Chaima-Jabri/Self-Balancing-Robot/Presentation&Rapport/Presentation projet CAO.pptx.pdf

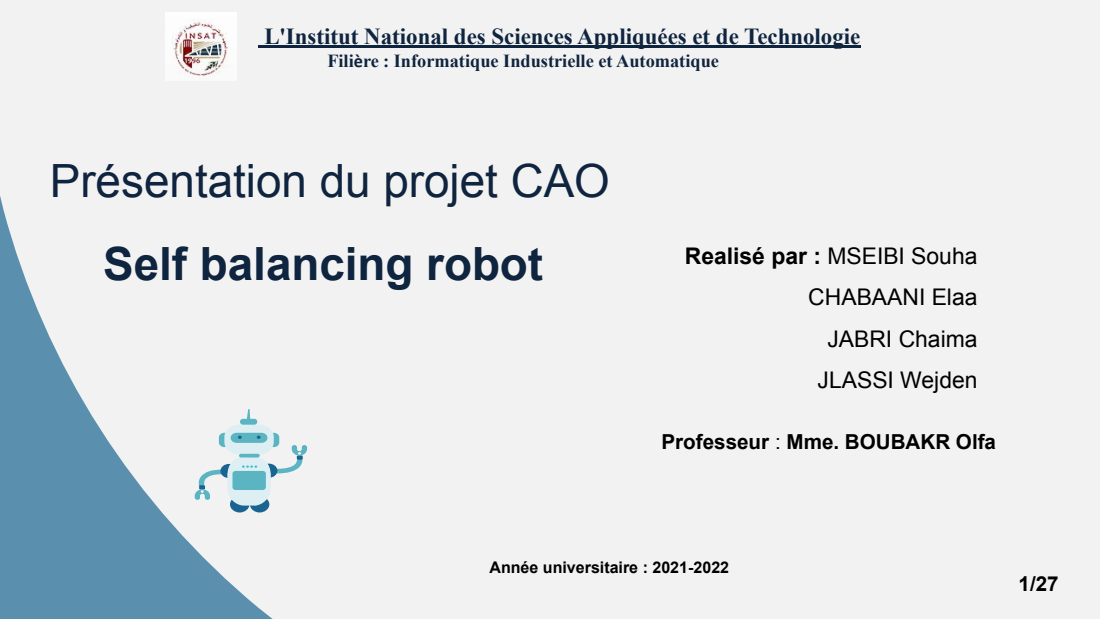
[picture p1: page 1]
Self balancing robot; Realisé par : MSEIBI Souha; CHABAANI Elaa; JABRI Chaima; JLASSI Wejden; Année universitaire : 2021-2022

L'Institut National des Sciences Appliquées et de Technologie

Filière : Informatique Industrielle et Automatique

Présentation du projet CAO

Professeur : Mme. BOUBAKR Olfa

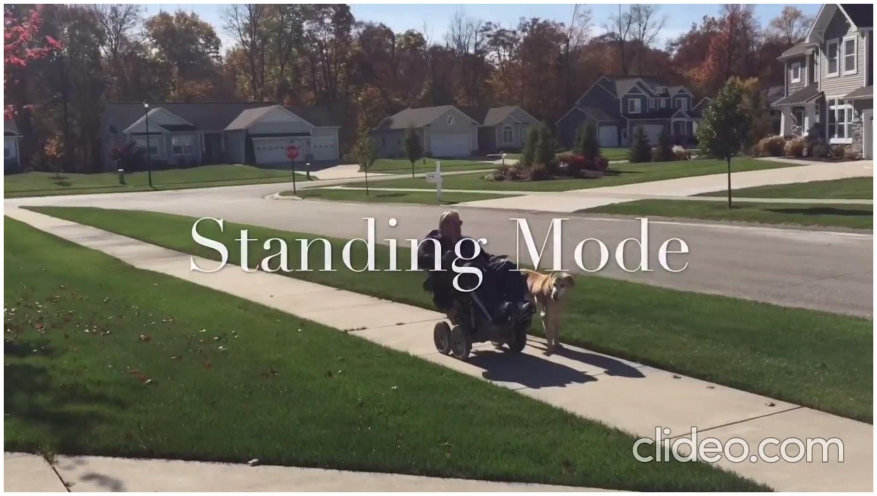
[picture p2: page 2]

Exemple d'application réel du concept d'un robot auto équilibrant (https://docs.google.com/file/d/1WviOFnjOAZ5Zq5dg2Hx27nzAXcQrJKgC/preview)

# Plan

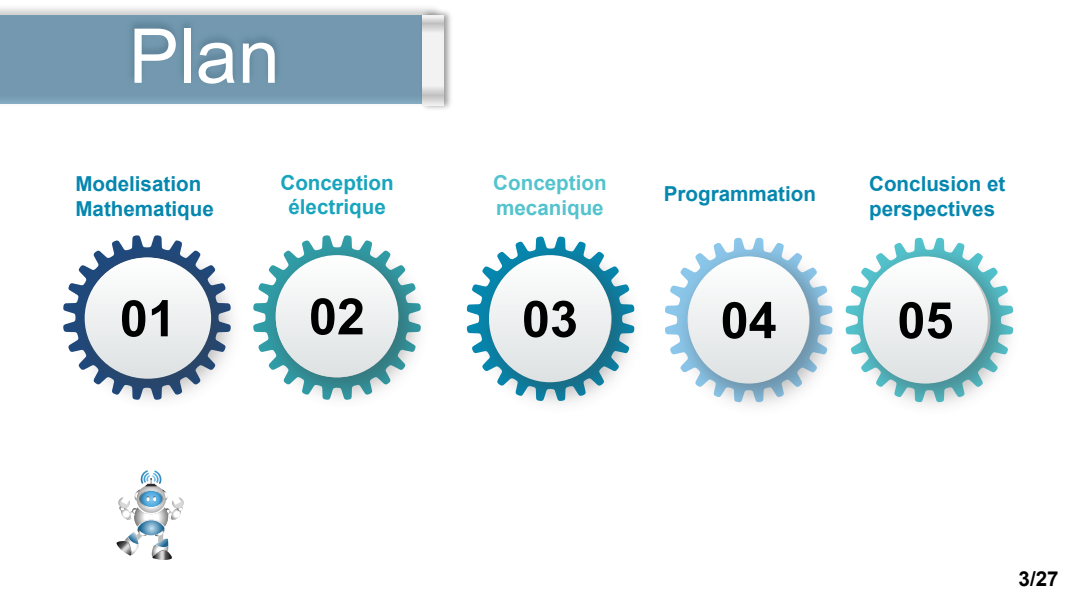
[picture p3: page 3]
Modelisation Mathematique; Conception électrique; Conception; mecanique; Programmation; Conclusion et; perspectives

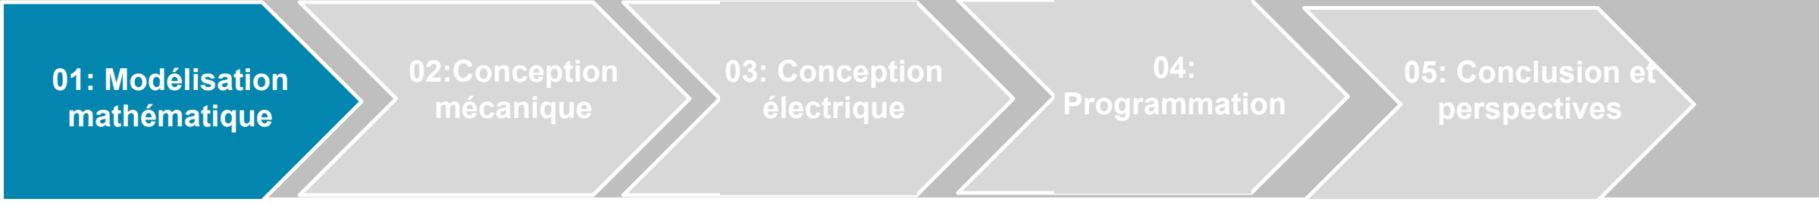
[picture p4: figure]
01: Modélisation mathématique; 02:Conception mécanique; 03: Conception électrique; 04: Programmation; 05: Conclusion et perspectives

## Modélisation et équations mathématiques :

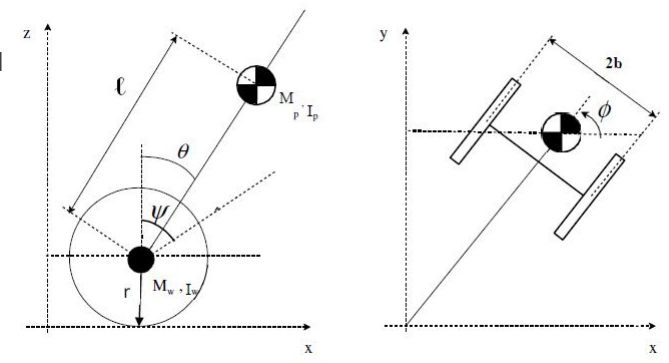
[picture p5: figure]

| on peut modéliser le robot en un sous-système mécanique qui se compose du corps du robot et de deux roues.
| Le corps peut être modélisé comme un pendule inversé avec la masse concentrée au centre de gravité et l'axe de rotation au-dessus de l'axe de roues.

4/27

## Assignations des variables

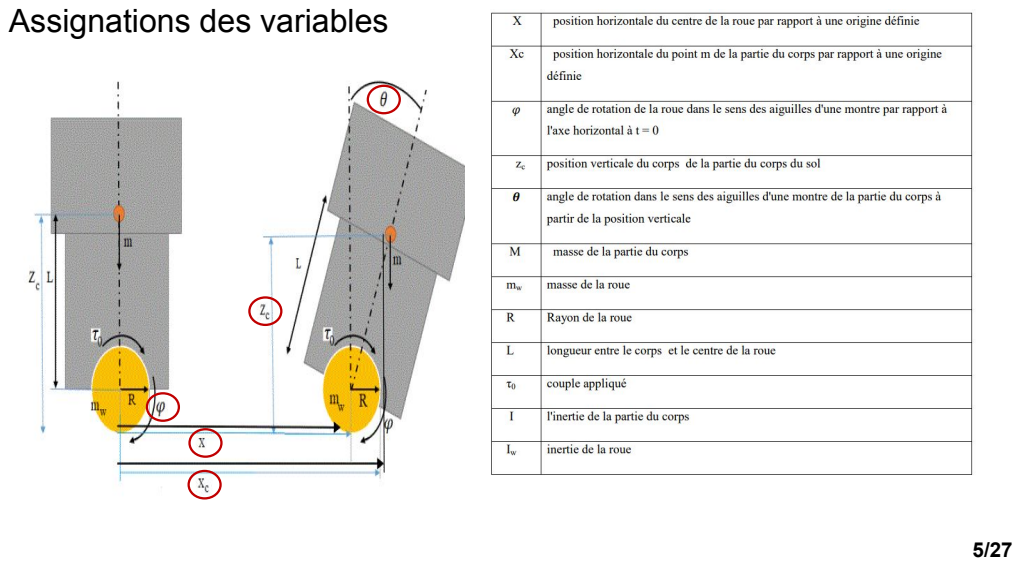
[picture p6: page 5]

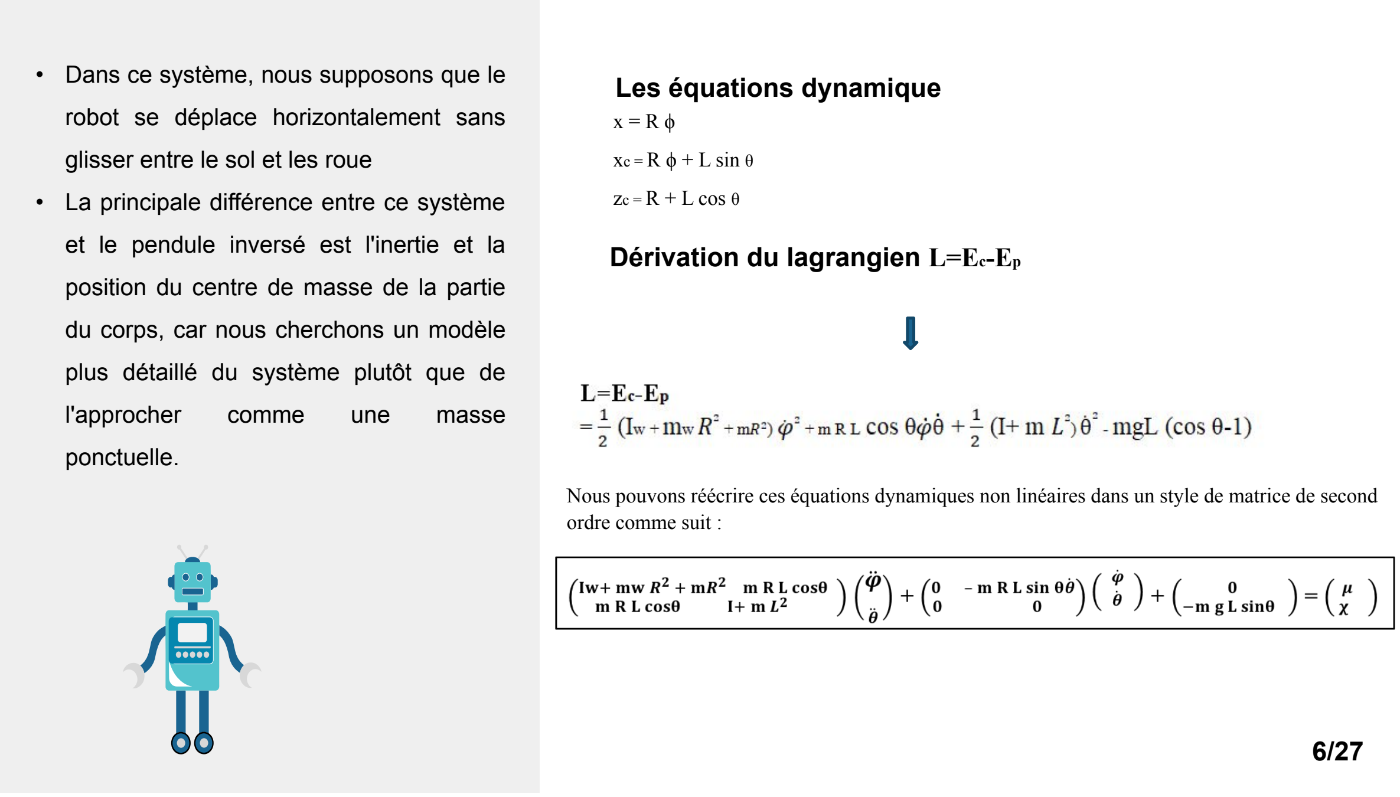
[picture p7: figure]
robot se déplace horizontalement sans; glisser entre le sol et les roue; du corps, car nous cherchons un modèle; plus détaillé du système plutôt que de; l'approcher; comme; une; masse; ponctuelle.; xc = R ϕ + L sin θ; zc = R + L cos θ; Dérivation du lagrangien L=Ec⁻Ep; ordre comme suit :

Les équations dynamique • Dans ce système, nous supposons que le

- La principale différence entre ce système

et le pendule inversé est l'inertie et la

position du centre de masse de la partie

Nous pouvons réécrire ces équations dynamiques non linéaires dans un style de matrice de second

## Conception électrique :

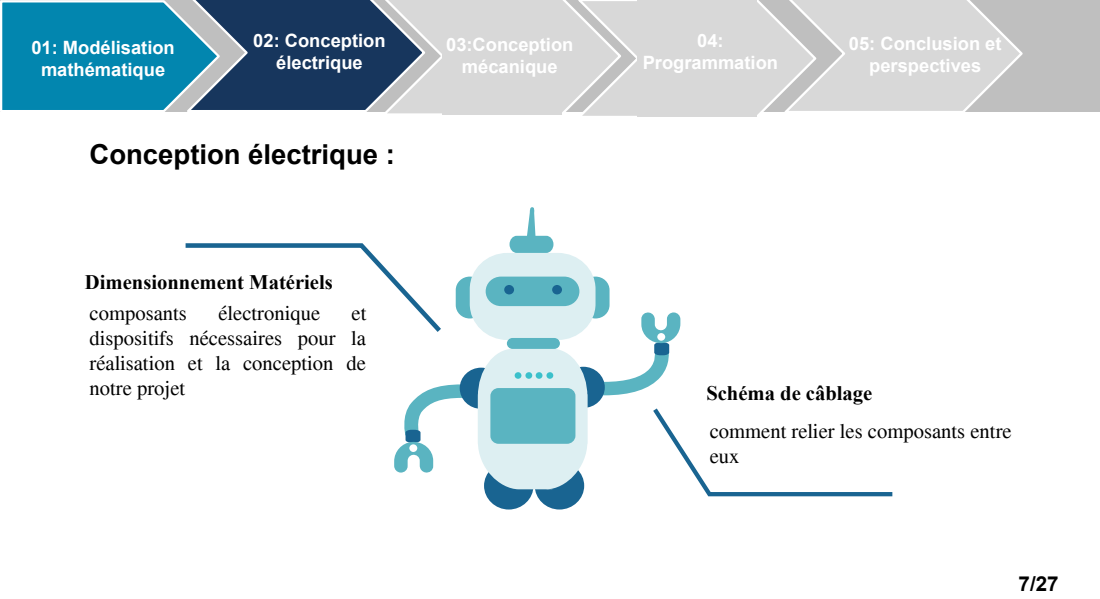
[picture p8: page 7]
01: Modélisation mathématique; 03:Conception mécanique; 02: Conception électrique; 04: Programmation; 05: Conclusion et perspectives; composants; électronique

Dimensionnement Matériels
dispositifs nécessaires pour la
réalisation et la conception de
notre projet

Schéma de câblage

comment relier les composants entre
eux

## Dimensionnement Matériels

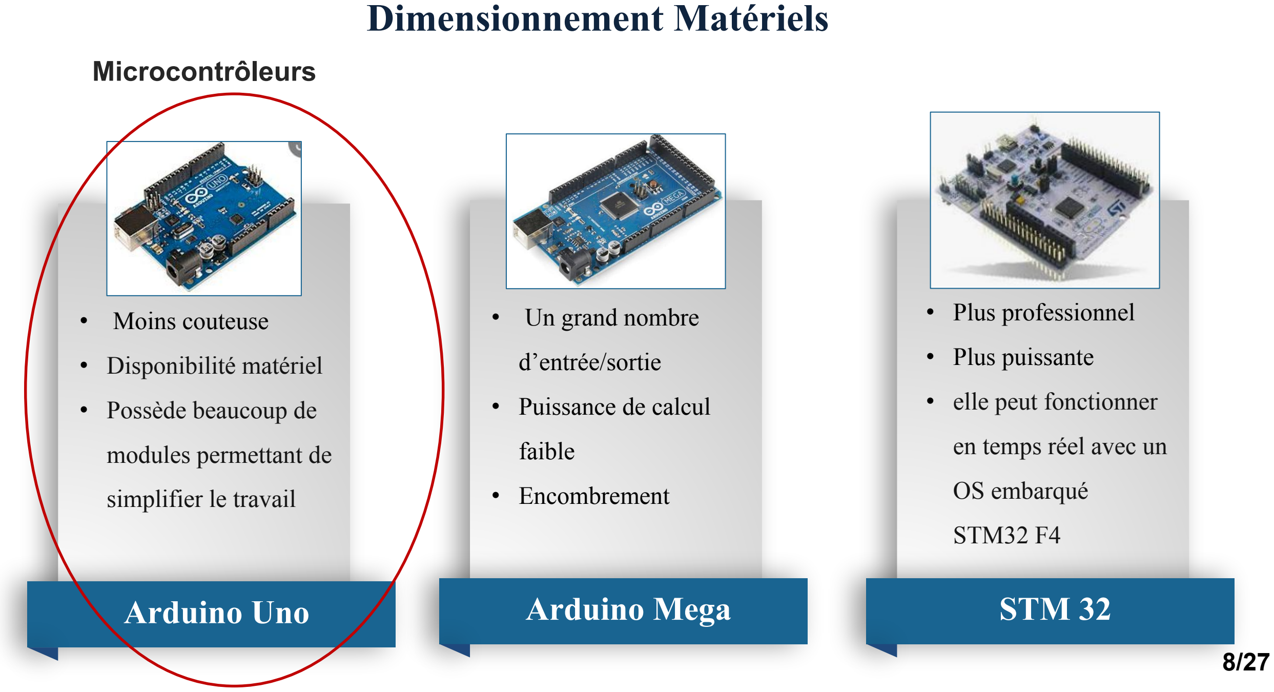
[picture p9: page 8]

### Microcontrôleurs

## Arduino Uno

- Moins couteuse
- Disponibilité matériel
- Possède beaucoup de

modules permettant de

simplifier le travail

## Arduino Mega

- Un grand nombre

d’entrée/sortie

- Puissance de calcul

faible

- Encombrement

## STM 32

- Plus professionnel
- Plus puissante
- elle peut fonctionner

en temps réel avec un

OS embarqué

STM32 F4

8/27

## Dimensionnement Matériels

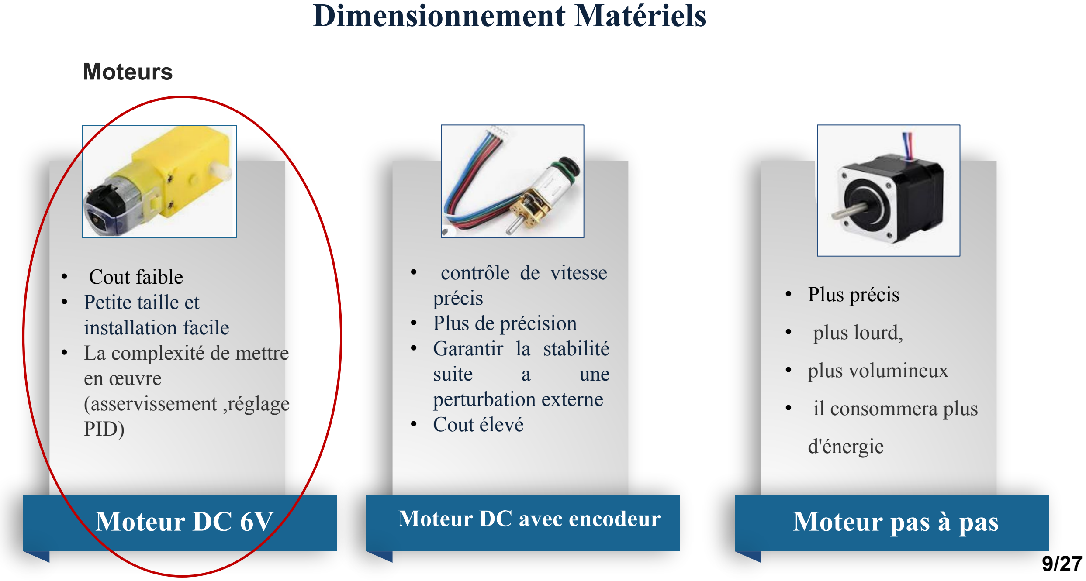
[picture p10: page 9]

### Moteurs

## Moteur DC 6V

- Cout faible
- Petite taille et
installation facile
- La complexité de mettre
en œuvre
(asservissement ,réglage
PID)
Moteur DC avec encodeur | Moteur pas à pas
- Plus précis
- plus lourd,
- plus volumineux
- il consommera plus

d'énergie

- contrôle de vitesse
précis
- Plus de précision
- Garantir la stabilité
suite | a | une
perturbation externe
- Cout élevé

9/27

## Dimensionnement Matériels

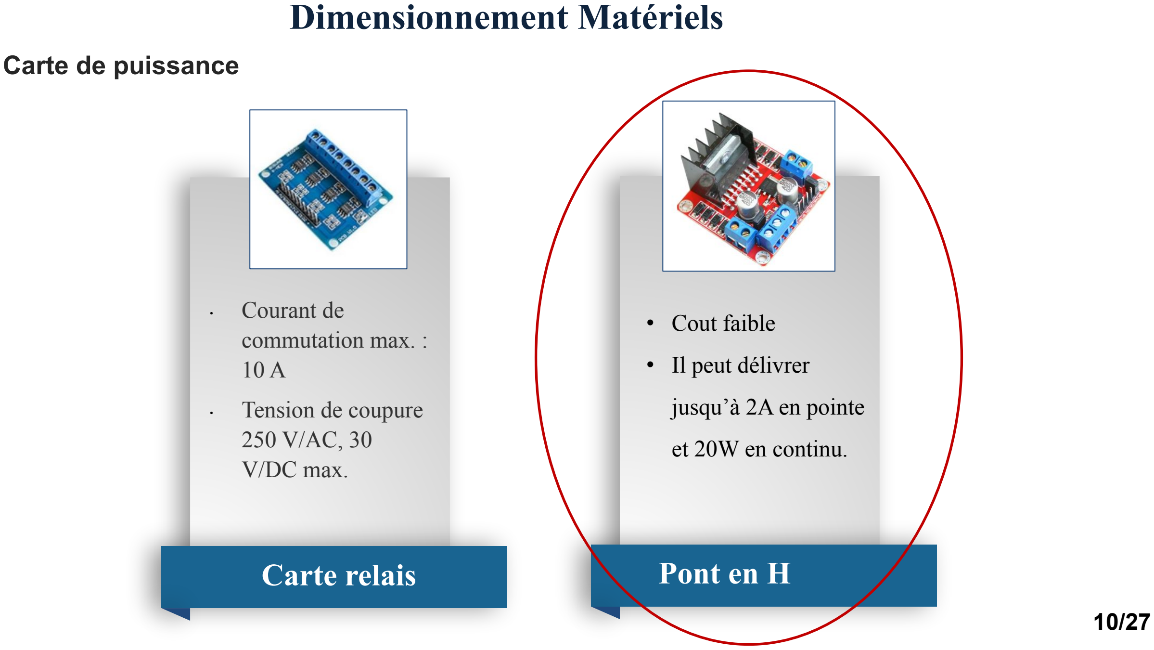
[picture p11: page 10]

### Carte de puissance

## Carte relais

- Courant de
commutation max. :
10 A
- Tension de coupure
250 V/AC, 30
V/DC max.
- Cout faible
- Il peut délivrer

jusqu’à 2A en pointe

et 20W en continu.

## Pont en H

10/27

## Dimensionnement Matériels

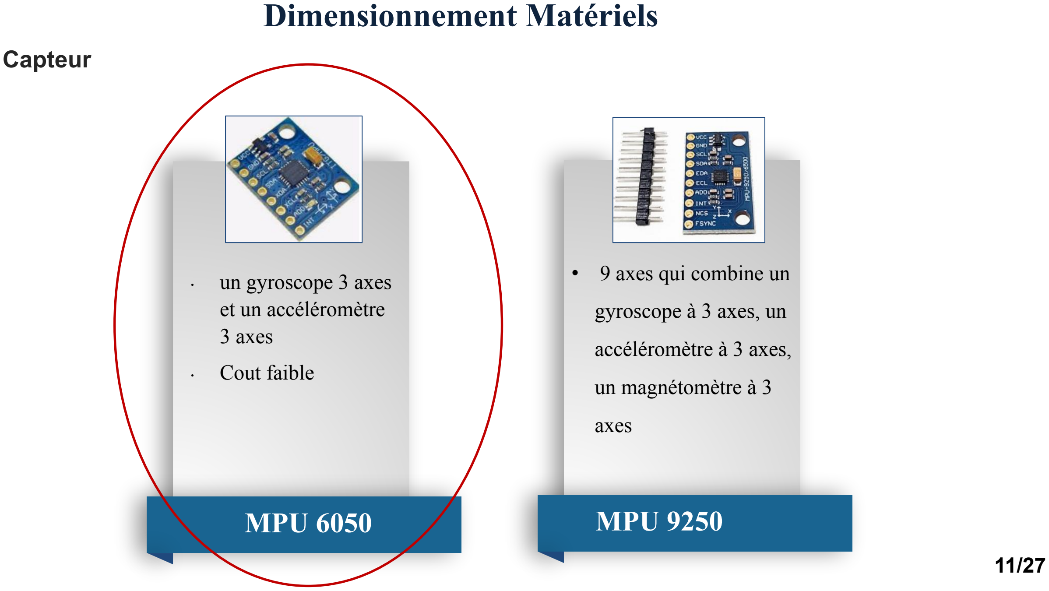
[picture p12: page 11]

### Capteur

## MPU 6050

- un gyroscope 3 axes
et un accéléromètre
3 axes
- Cout faible
- 9 axes qui combine un

gyroscope à 3 axes, un

accéléromètre à 3 axes,

un magnétomètre à 3

axes

## MPU 9250

11/27

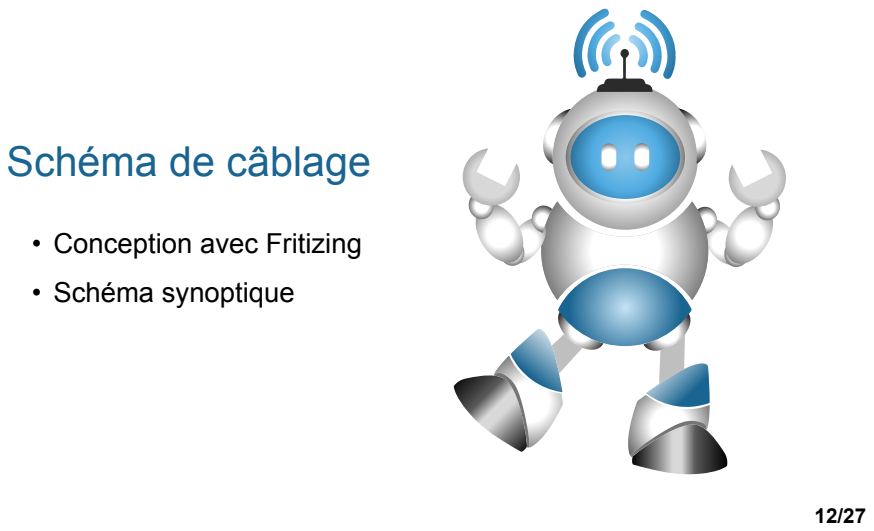
[picture p13: page 12]
• Schéma synoptique

Schéma de câblage

• Conception avec Fritizing

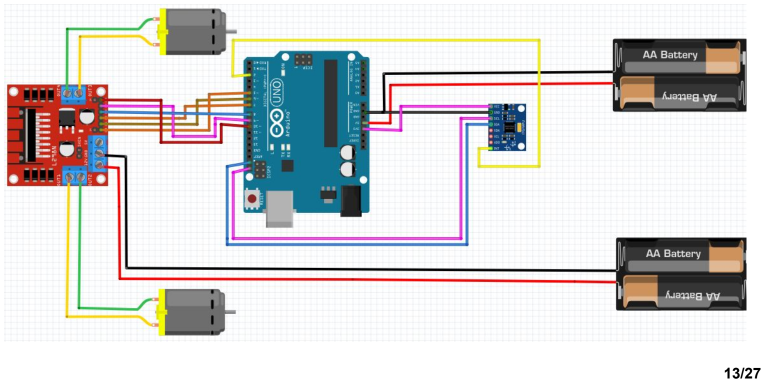
[picture p14: page 13]

13/27

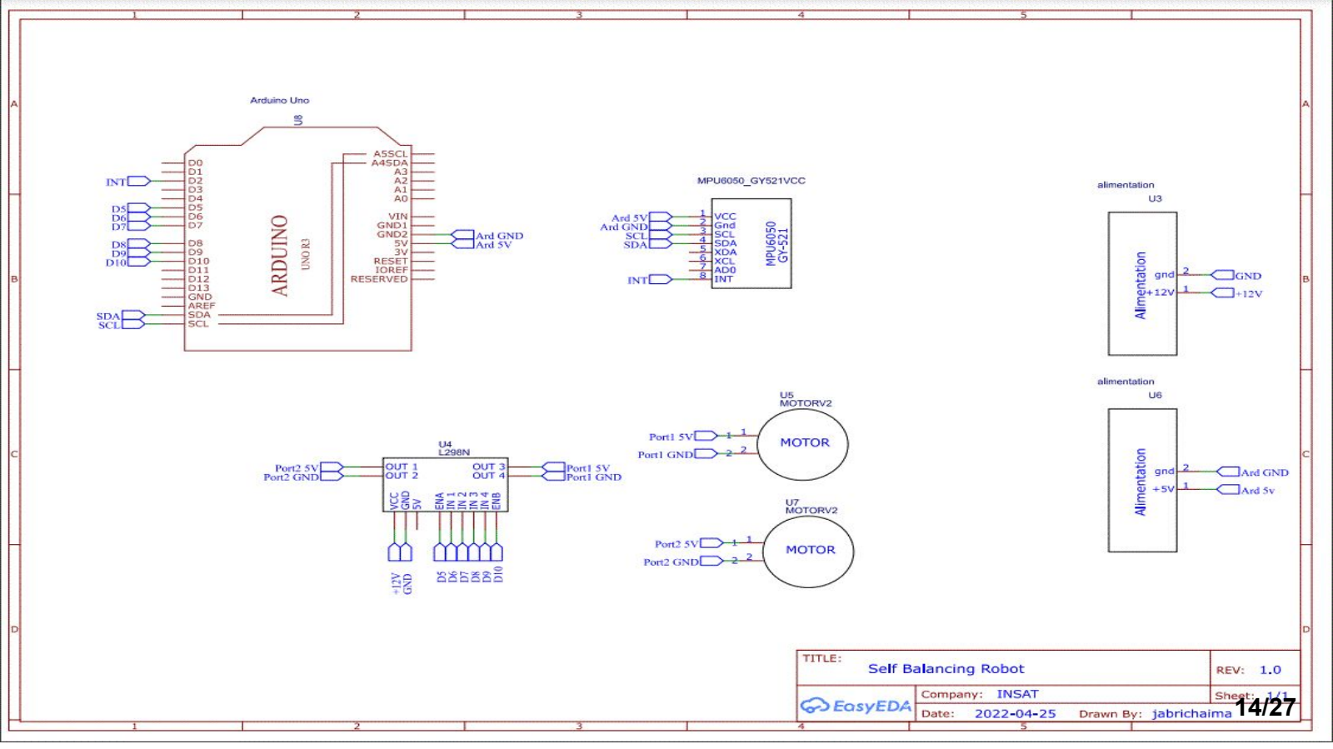
[picture p15: page 14]

14/27

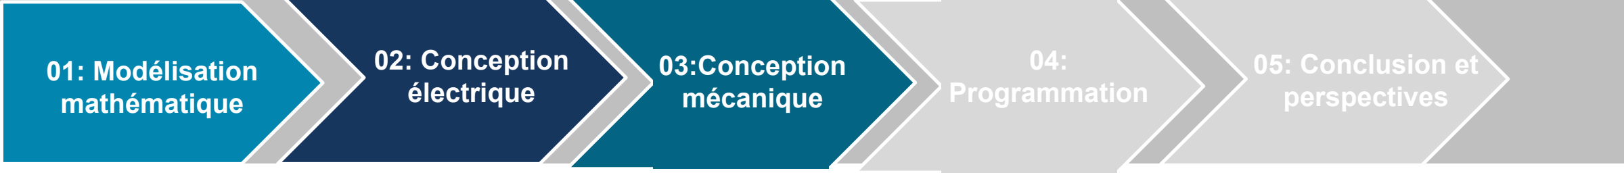
[picture p16: figure]
01: Modélisation mathématique; 03:Conception mécanique; 02: Conception électrique; 04: Programmation; 05: Conclusion et perspectives

## Conception Mécanique de la Version finale de robot :

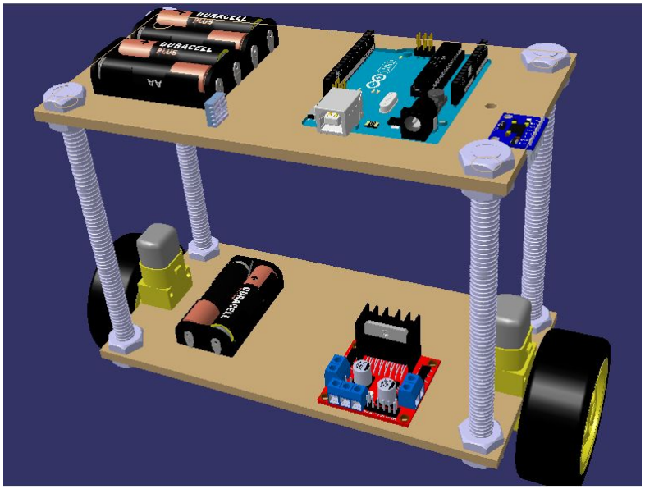
[picture p17: figure]

15/27

# Vue éclatée

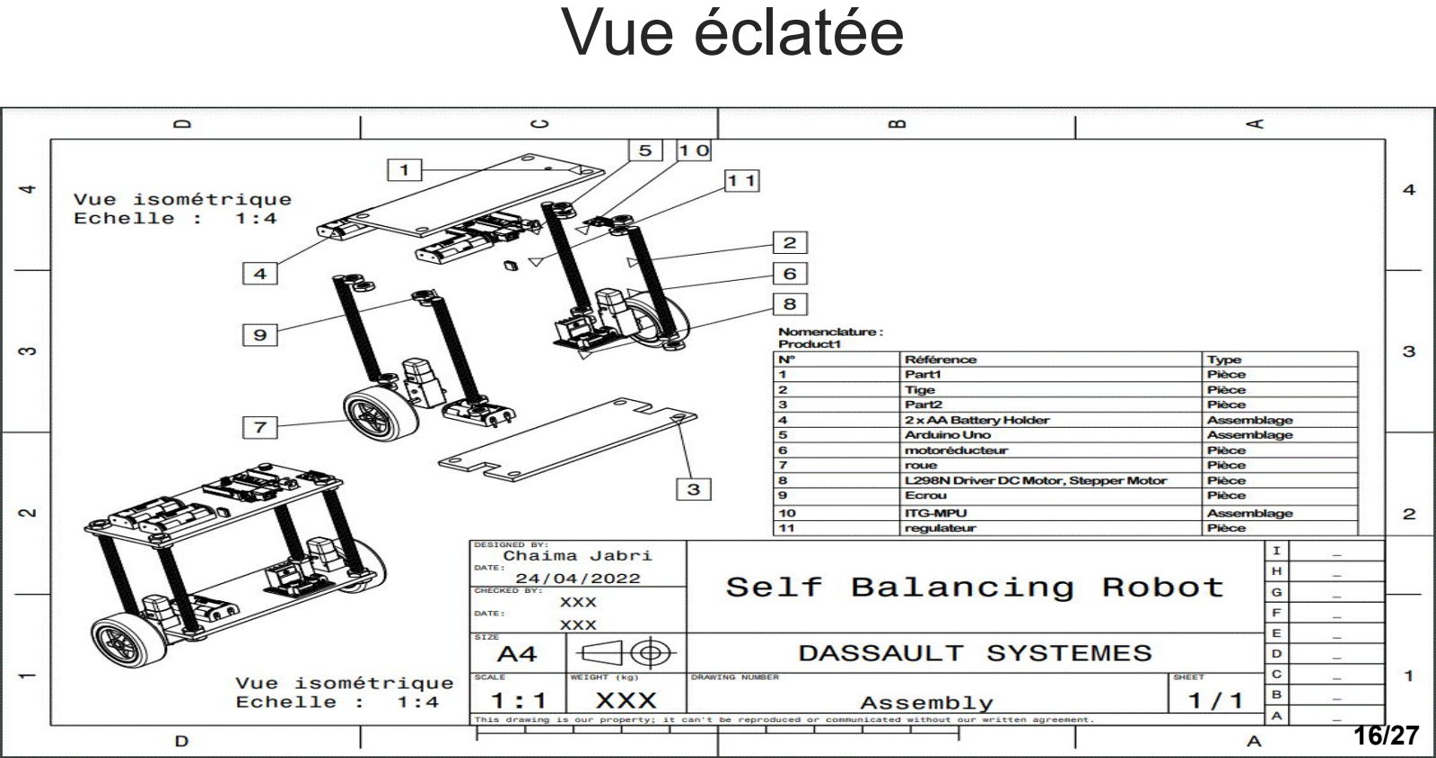
[picture p18: page 16]

16/27

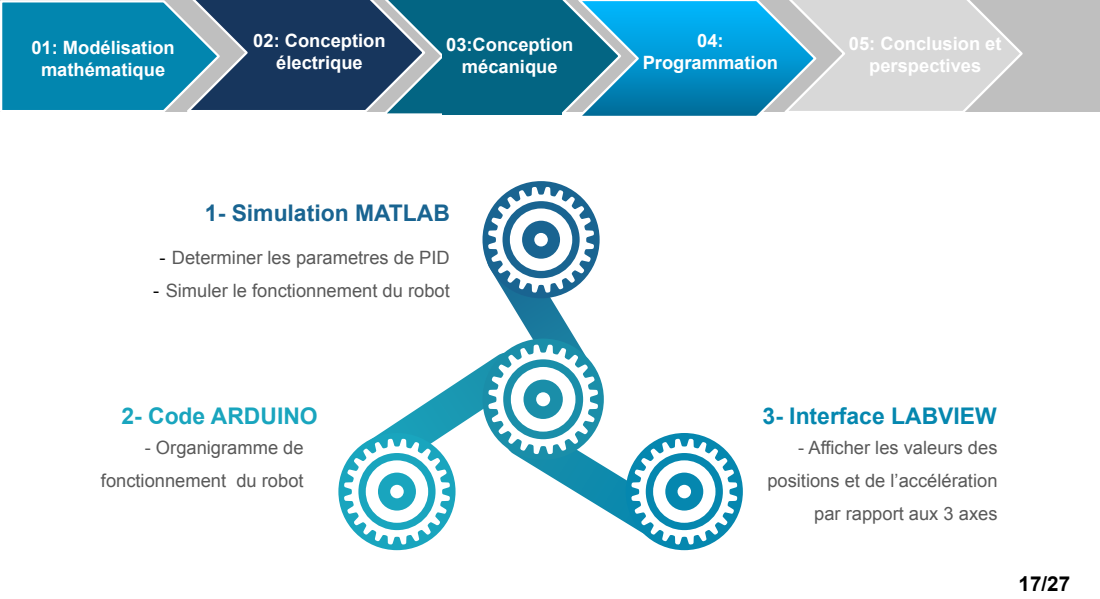
[picture p19: page 17]
3- Interface LABVIEW; 1- Simulation MATLAB; - Organigramme de; 2- Code ARDUINO; 01: Modélisation mathématique; 03:Conception mécanique; 02: Conception électrique; 04: Programmation; 05: Conclusion et perspectives

- Determiner les parametres de PID

- Simuler le fonctionnement du robot

- Afficher les valeurs des

fonctionnement du robot

positions et de l’accélération

par rapport aux 3 axes

# Régulateur PID

## Schéma bloc Régulateur PID :

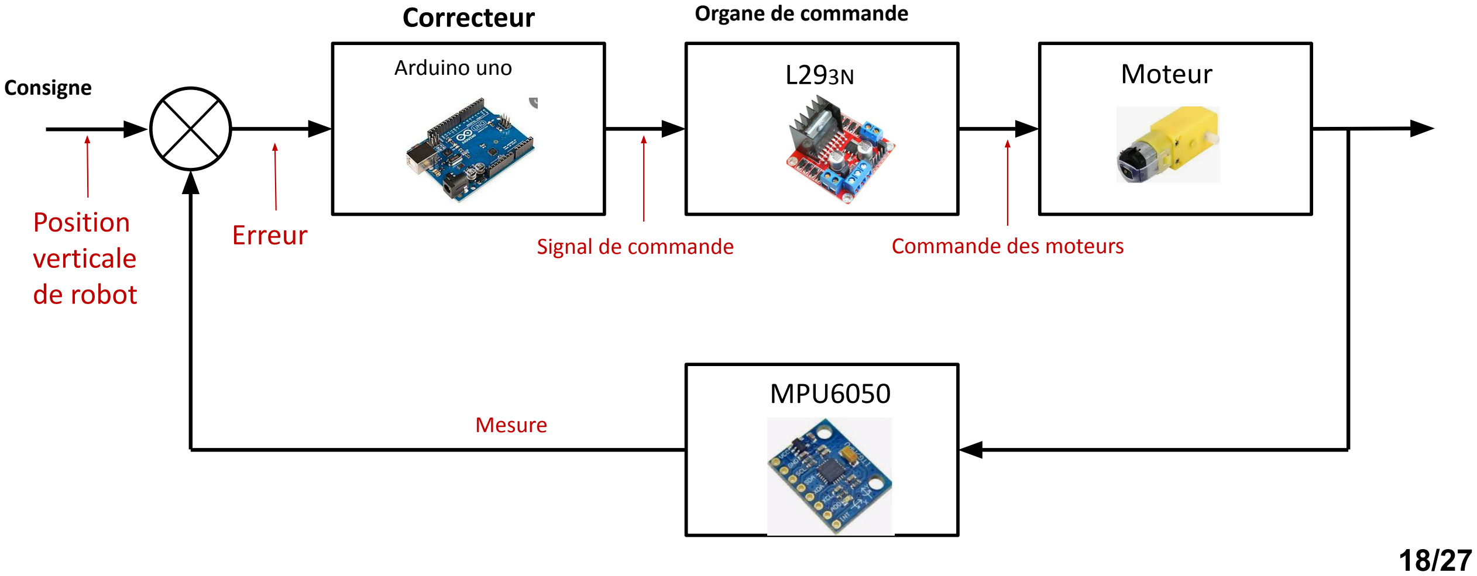
[picture p20: figure]
Consigne; Position verticale de robot; Correcteur; Arduino uno; Organe de commande; Moteur; MPU6050; Erreur; Signal de commande; Commande des moteurs; Mesure

### 1- Simulation MATLAB

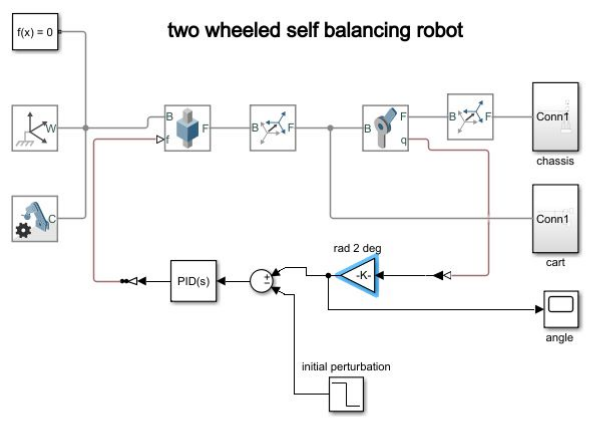
[picture p21: figure]

19/27

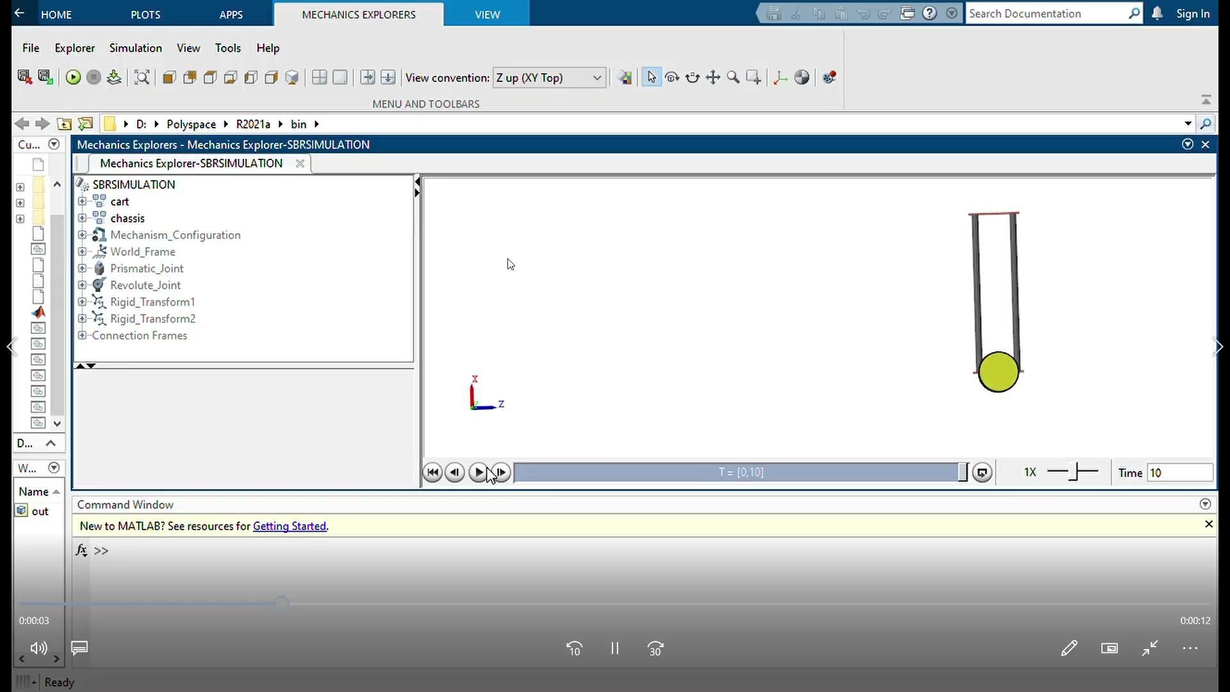
[picture p22: page 20]
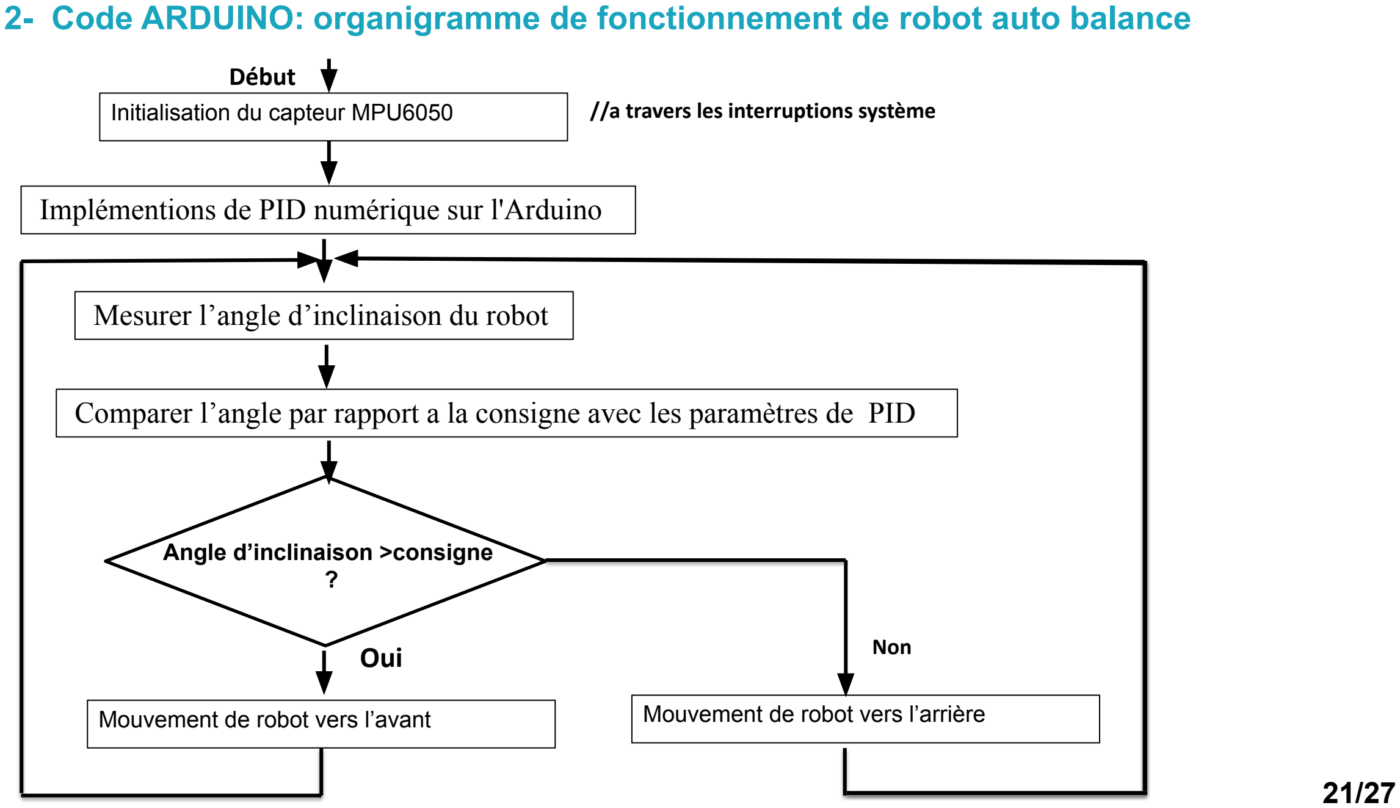
[picture p23: page 21]

### 2- Code ARDUINO: organigramme de fonctionnement de robot auto balance

Initialisation du capteur MPU6050 | //a travers les interruptions système

Implémentions de PID numérique sur l'Arduino

Mesurer l’angle d’inclinaison du robot

Comparer l’angle par rapport a la consigne avec les paramètres de PID

Angle d’inclinaison >consigne ?

Mouvement de robot vers l’avant

Oui | Non
| Mouvement de robot vers l’arrière

Début

21/27

### 3- Interface LABVIEW

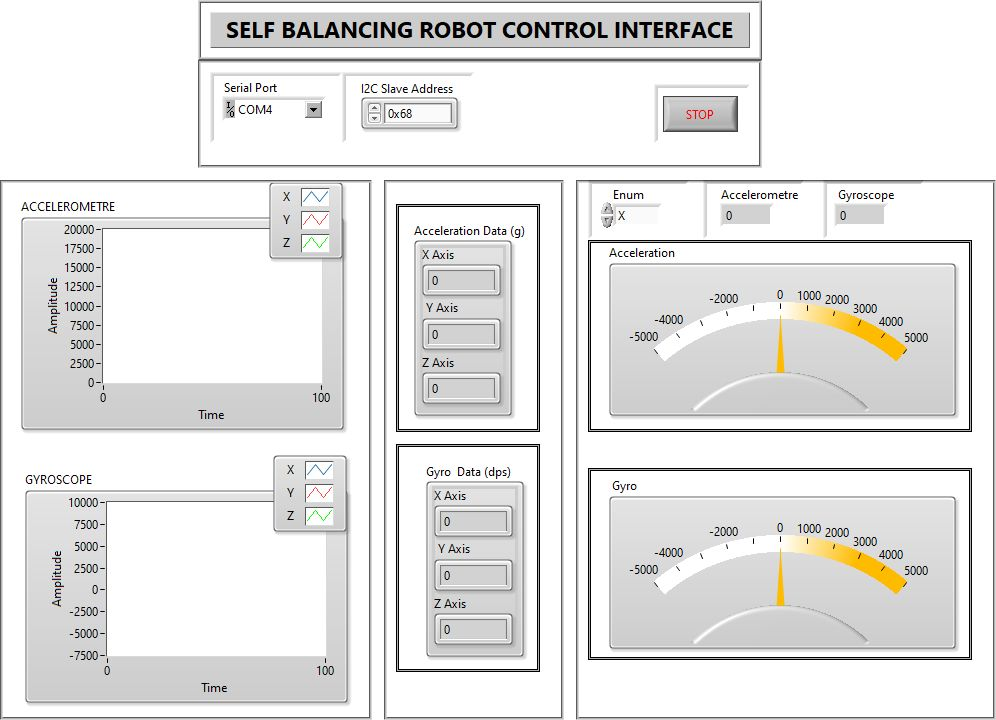
[picture p24: figure]

22/27

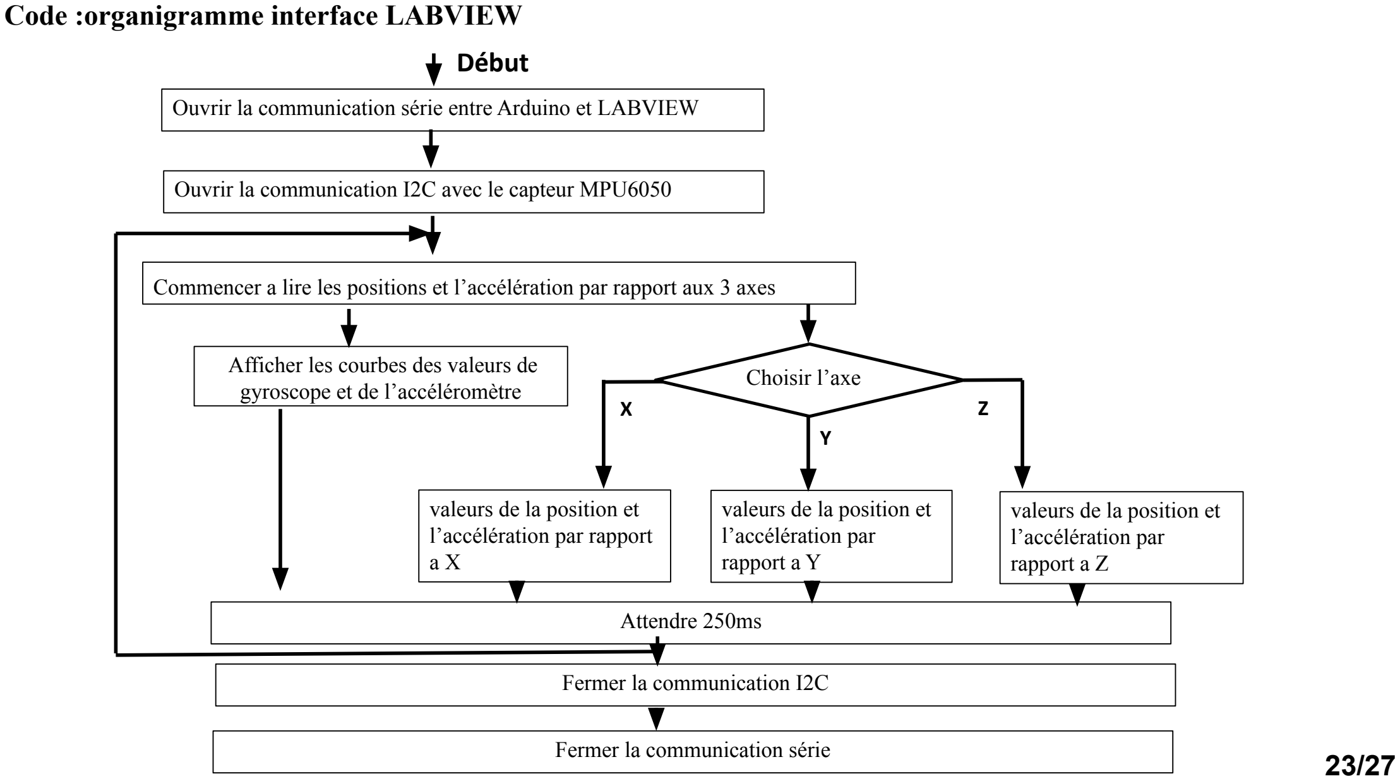
[picture p25: figure]
Code :organigramme interface LABVIEW; Début; Afficher les courbes des valeurs de; gyroscope et de l’accéléromètre; Choisir l’axe; valeurs de la position et l’accélération par rapport a X; valeurs de la position et l’accélération par rapport a Y; valeurs de la position et l’accélération par rapport a Z; Attendre 250ms; Fermer la communication I2C; Fermer la communication série

Ouvrir la communication série entre Arduino et LABVIEW

Ouvrir la communication I2C avec le capteur MPU6050

Commencer a lire les positions et l’accélération par rapport aux 3 axes

# Vidéo simulation de fonctionnement

24/27

# Vidéo simulation de fonctionnement

24/27

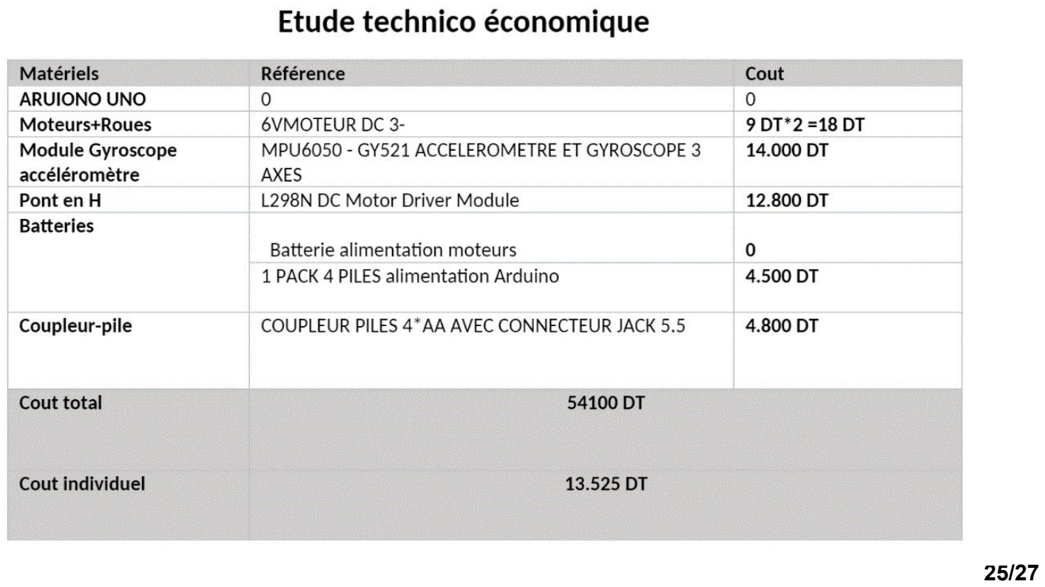
[picture p26: page 26]

25/27

Nous avons commencé notre étude par une modélisation mathématique du système , par la suite nous avons travailler sur la conception électrique du robot : dimensionnement matériels et schéma de câblage .
nous avons étudié la conception mécanique : les dimensions ainsi que le positionnement du matériels afin de garantir la stabilité de robot et finalement nous avons développé le code nécessaire au fonctionnement et l’interface de controle avec Labview

# Conclusion

26/27

Durant la réalisation de ce projet , on n'a pas réussi à bien équilibré le robot et le réguler , à cause de mauvais fonctionnement de l'accéléromètre MPU ,
même avec la calibration de la sensitivité du capteur on n'a pas réussi à établir la connection entre la carte arduino et le capteur , du coup , des valeurs erronées étant rendu par le MPU . ça peut être expliqué par un défaut au pin de clock ou serial data .

# Perspective

27/27

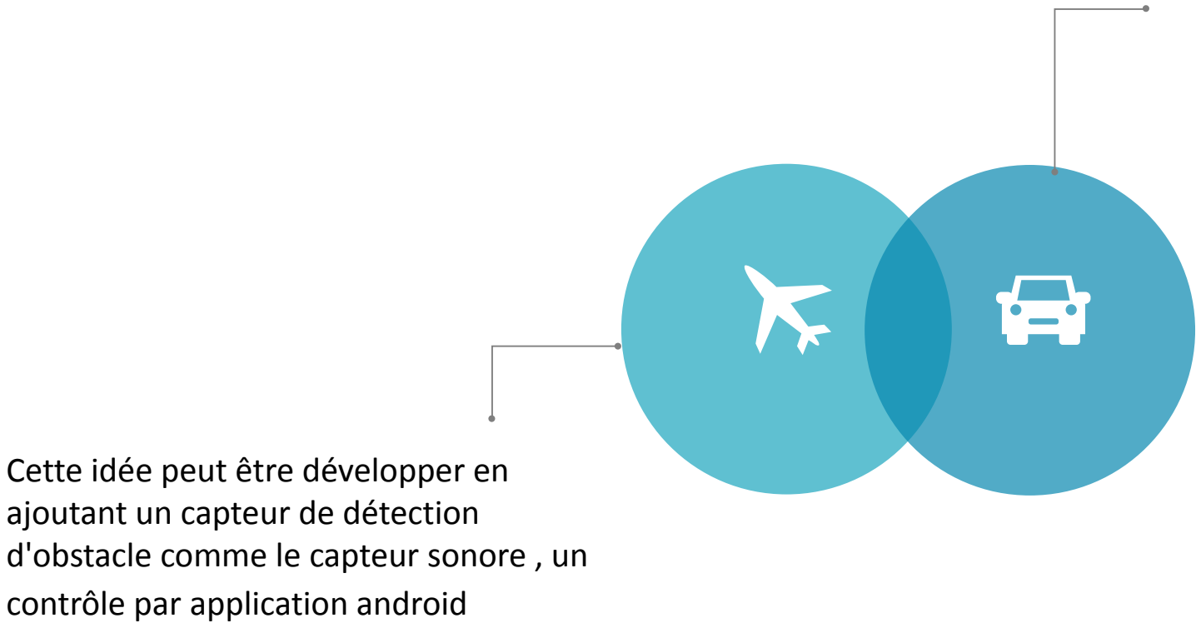
[picture p27: figure]
Cette idée peut être développer en ajoutant un capteur de détection d'obstacle comme le capteur sonore , un contrôle par application android
