Chaima-Jabri/Self-Balancing-Robot/Etude théorique/Modelisation-mathematique.pdf

Equation dynamique :

L’énergie potentielle Ep :
Ep = mg (R + L cos θ) – mg(R+L) = mgL (cos θ-1)

L’énergie cinétique Ec :

Ec = 1
2

mw ẋ

2
+

1
2

Iw φ̇

2
+

1
2

m xċ

2
+

1
2

m zċ

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
(Iw + mw R

2
+ mR

2

) φ̇

2

+ m R L cos θφ̇ θ̇ +

1
2

(I+ m L

2
) θ

̇

2

Dérivation du lagrangien

Par conséquent, les équations dynamiques pour la coordonnée ϕ et la coordonnée θ peuvent être dérivées comme suit :

Avec coordonné φ

∂L
∂φ̇

= (Iw+ mw R

2 + mR

2

) φ̇+ mRL θ̇ cos θ

∂L
∂φ

= 0

d
dt (

∂L
∂φ̇

) -

∂L
∂φ

= (Iw+ mw R

2 + mR

2

) φ̈+ m R L cosθθ̈– m R L sin θθ̇² = μ

Avec coordonné θ

x = R ϕ
xc = R ϕ + L sin θ
zc = R + L cos θ

ẋ = R φ̇
xċ =Rφ̇ + Lθ̇ cos θ
zċ = -L θ̇ sin θ

L=Ec-Ep
=

1
2

(Iw + mw R

2
+ mR

2

) φ̇

2

+ m R L cos θφ̇ θ̇ +

1
2

(I+ m L

2
) θ

̇

2
- mgL (cos θ-1)

∂L
∂θ̇

= m R L cos θ φ̇ + (1+mL

2

) θ̇

∂L
∂θ̇

= -m R L φ̇ sinθθ̈+ mgL sinθ

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
= (I+ m L

2

) θ̈+ m R L cosθφ̈ – m g L sin θ = χ μ et χ sont des forces généralisées (couples) pour chaque coordonnée

Nous pouvons réécrire ces équations dynamiques non linéaires dans un style de matrice de second ordre comme suit :

(
Iw+ mw R

2 + mR

2 m R L cosθ
m R L cosθ | I+ m L
2 | ) (

φ̈

θ̈

) + (
0 | – m R L sin θθ̇
0 | 0

) (

φ̇
θ̇ ) + (
0
−m g L sinθ

) = (
μ
χ

)
