Chaima-Jabri/Self-Balancing-Robot/Conception électrique/schema.PNG

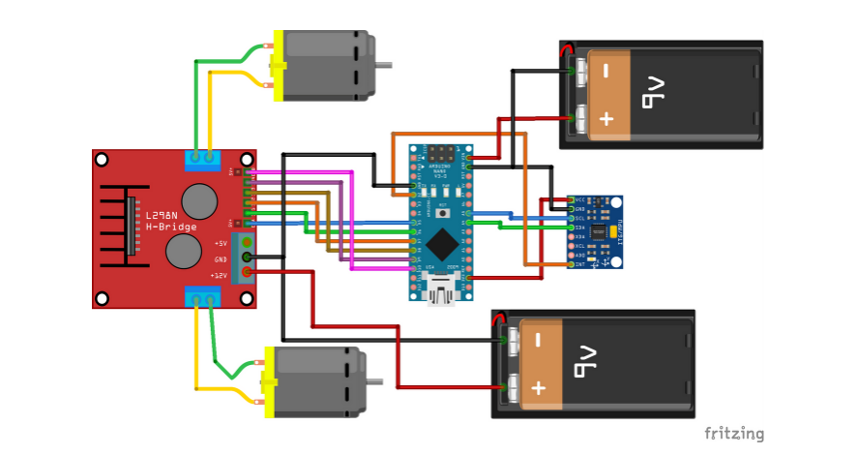
Conception électrique/schema.PNG
