Chaima-Jabri/Self-Balancing-Robot/(list of files, cad)

Other CAD files:
Conception mécanique/8 Header-Pin.CATPart
Conception mécanique/AA Duracell Body.CATPart
Conception mécanique/Ardi_UNO.CATProduct
Conception mécanique/Ardi_UNO_Platine_001.CATPart
Conception mécanique/Battery.CATProduct
Conception mécanique/Contact.CATPart
Conception mécanique/Headers_Analog_001.CATPart
Conception mécanique/Headers_digital_001.CATPart
Conception mécanique/Kondensator_A8-47-25V_001.CATPart
Conception mécanique/Kondensator_A8-47-25V_002.CATPart
Conception mécanique/L298N Driver DC Motor, Stepper Motor.CATPart
Conception mécanique/LED Arduino UNO gelb_001.CATPart
Conception mécanique/LED Arduino UNO gelb_002.CATPart
Conception mécanique/LED Arduino UNO gelb_003.CATPart
Conception mécanique/MPU6050.CATProduct
Conception mécanique/Main body.CATPart
Conception mécanique/Negative Pin.CATPart
Conception mécanique/Part1.CATPart
Conception mécanique/Part2.CATPart
Conception mécanique/Pins_3fach_q_001.CATPart
Conception mécanique/Pins_3fach_q_002.CATPart
Conception mécanique/Placa_Base.CATPart
Conception mécanique/Positive Pin.CATPart
Conception mécanique/Quarz_Arduino_16_001.CATPart
Conception mécanique/Spring.CATPart
Conception mécanique/Stromanschluss_arduino UNO_001.CATPart
Conception mécanique/Tige.CATPart
Conception mécanique/Transistor Arduino UNO_001.CATPart
Conception mécanique/USB_typeB_001.CATPart
Conception mécanique/_NPart#729057.CATPart
Conception mécanique/achterTeil_001.CATPart
Conception mécanique/arduino uno.CATPart
Conception mécanique/assemblage.CATProduct
Conception mécanique/atmega328_001.CATPart
Conception mécanique/atmega328_socket_001.CATPart
Conception mécanique/ecrou.CATPart
Conception mécanique/moteur.CATPart
Conception mécanique/part 2 moteur.CATPart
Conception mécanique/part moteur.CATPart
Conception mécanique/regulateur.CATPart
Conception mécanique/resetButton UNO_001.CATPart
Conception mécanique/roue.CATPart
Conception mécanique/roue2.CATPart
