Chaima-Jabri/Self-Balancing-Robot/Conception mécanique/Assemblage.pdf

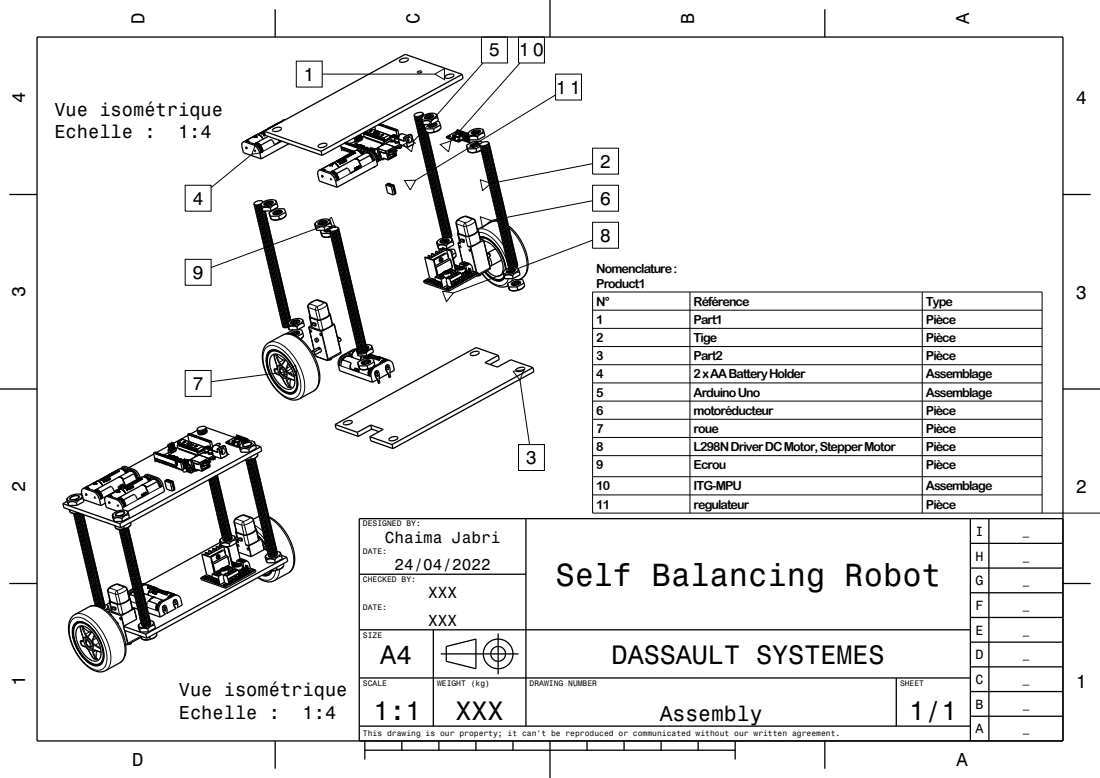
[picture p43: page 1]
WEIGHT (kg); DRAWING NUMBER; DASSAULT SYSTEMES; CHECKED BY:; DESIGNED BY: Chaima Jabri; Self Balancing Robot; 2 x AA Battery Holder; Assemblage; Arduino Uno; Vue isométrique Echelle : 1:4

Nomenclature :
Product1
8 L298N Driver DC Motor, Stepper Motor Pièce

This drawing is our property; it can't be reproduced or communicated without our written agreement.
