Chaima-Jabri/Self-Balancing-Robot/Conception électrique/easyEda.pdf

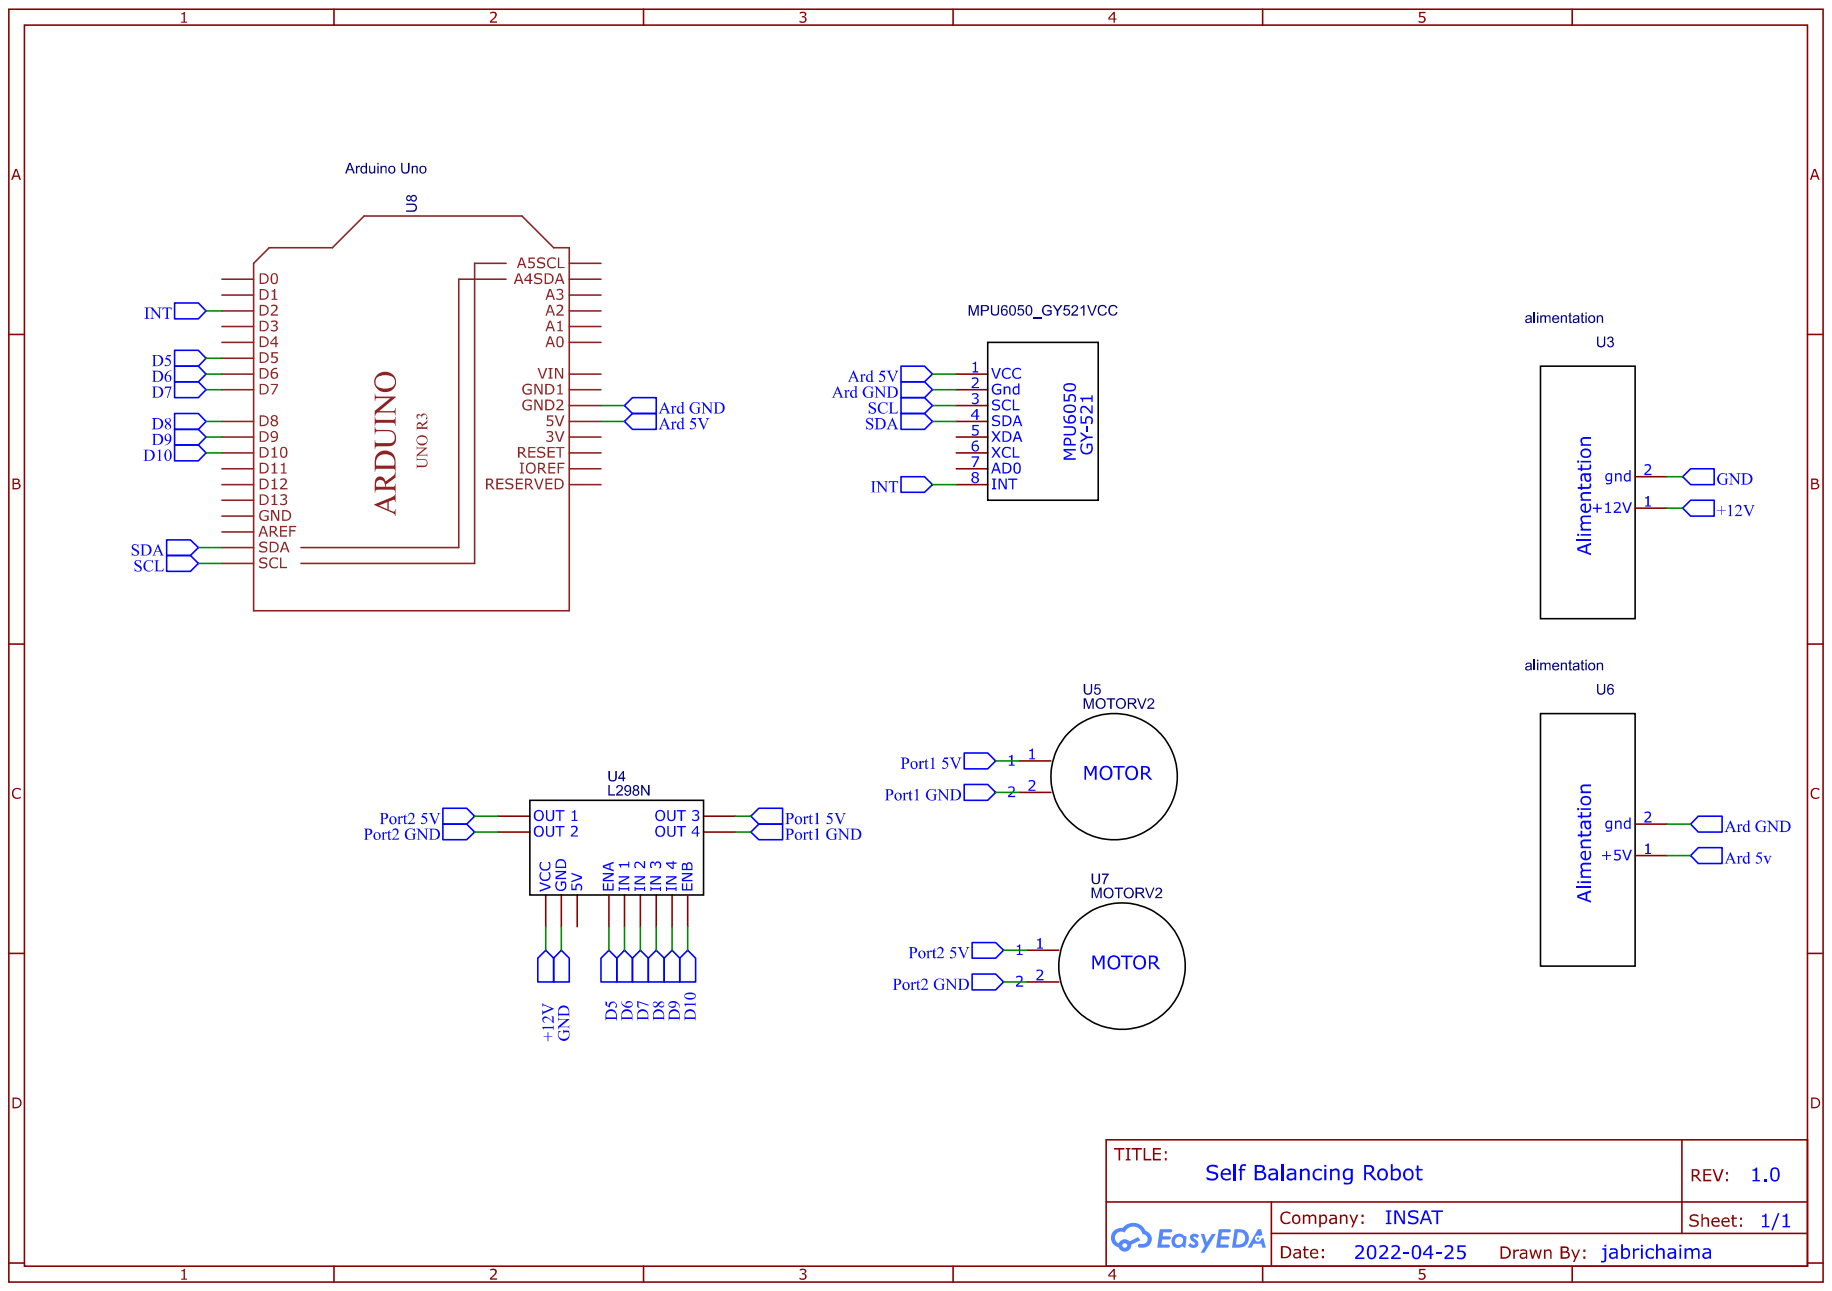
[picture p44: page 1]
