Chaima-Jabri/Self-Balancing-Robot/(list of files, drawings)

Other design files:
Conception électrique/Schema fritzing.fzz
